Claybarn/RoboIAP/pictures/calibrationButtons.jpeg

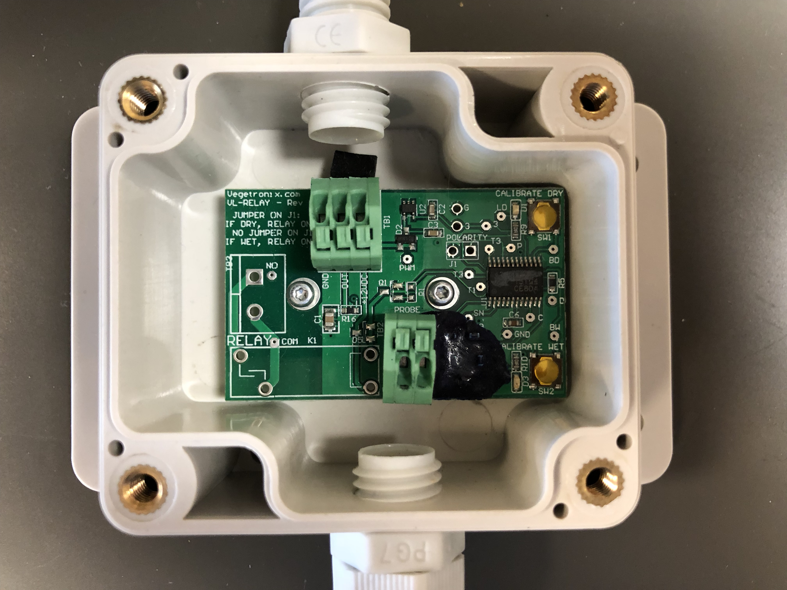
pictures/calibrationButtons.jpeg
