Claybarn/RoboIAP/(threads)

Thread 1 (2019-05-06):

Wire.requestFrom() should not be followed by Wire.endTransmission().

Koepel, 2019-05-06:
In the file "RoboIAP/code/sketches/workingi2cBridge.ino" the `TinyWireM.requestFrom()` is followed by a `TinyWireM.endTransmission()`. That `TinyWireM.endTransmission()` is at the moment at line 65 and can be removed.
Explanation: [Common-mistakes#2](https://github.com/Koepel/How-to-use-the-Arduino-Wire-library/wiki/Common-mistakes#2)
